ctech4285/EPM_V2_X/V2.50_Documentation/schematic2.jpg

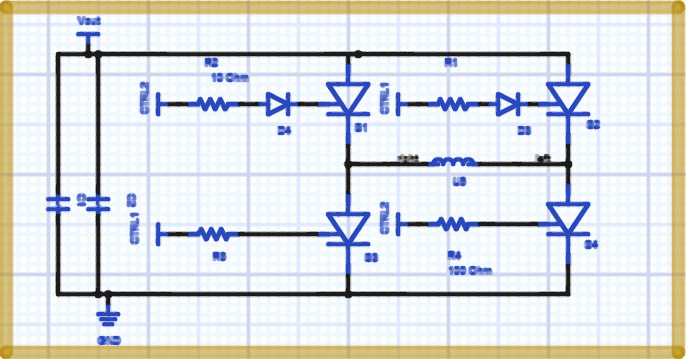
V2.50_Documentation/schematic2.jpg
