ctech4285/EPM_V2_X/PCB Mask R2.50/e768795934e55e3a_gerbers.gbl.png

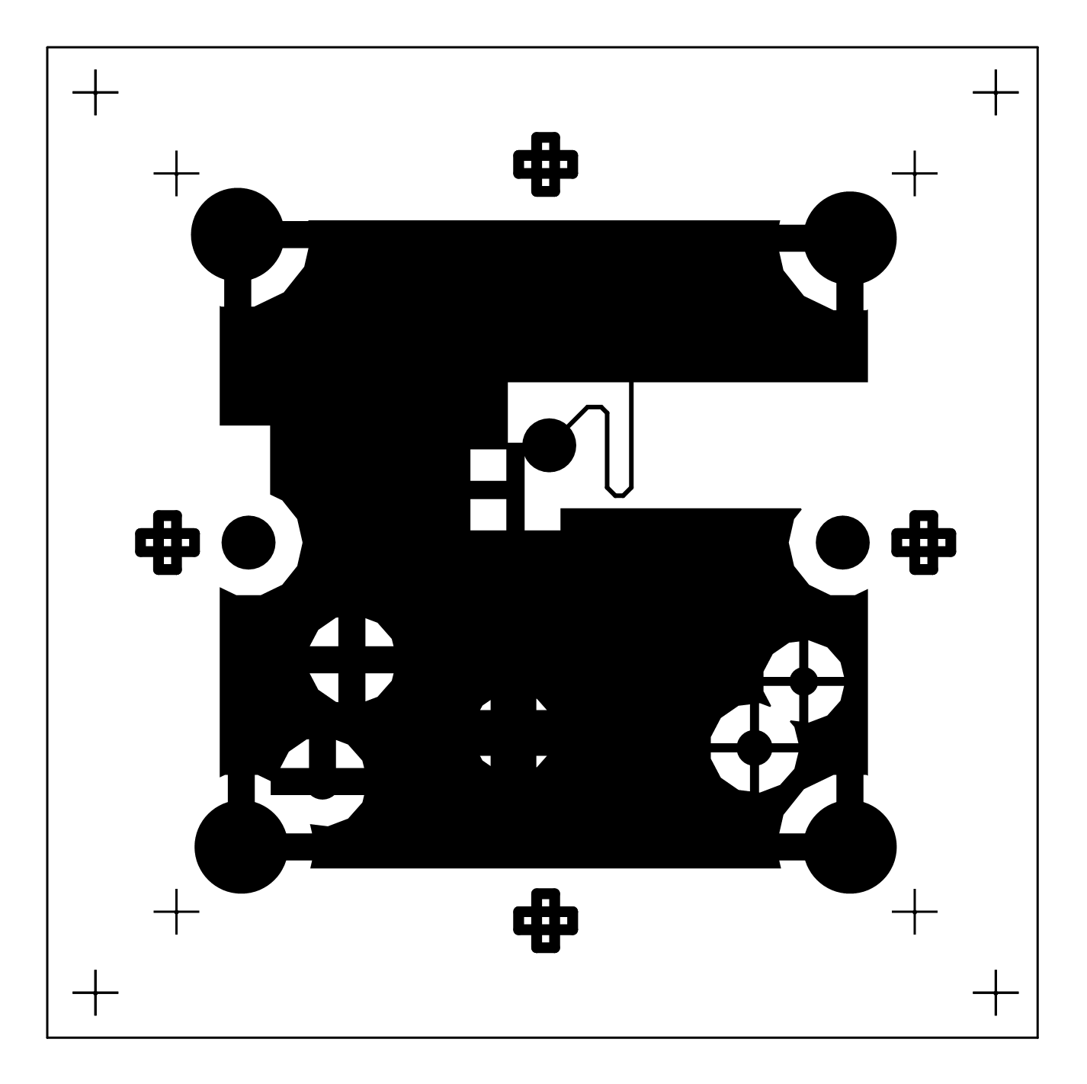
PCB Mask R2.50/e768795934e55e3a_gerbers.gbl.png
