ctech4285/EPM_V2_X/PCB Mask RC6/bottom_copper.ger.png

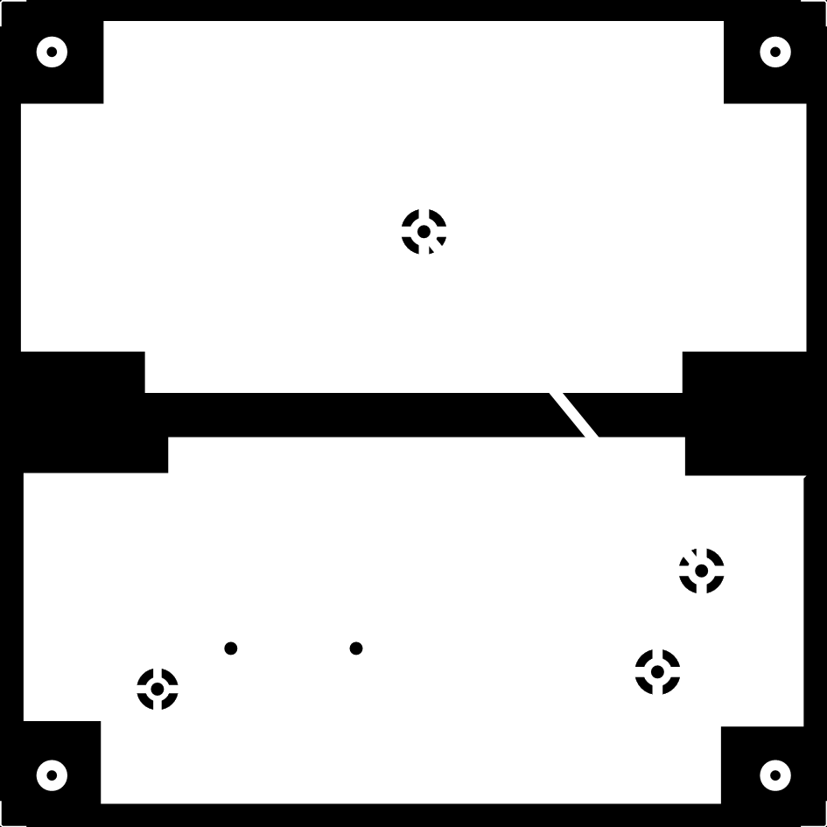
PCB Mask RC6/bottom_copper.ger.png
