ctech4285/EPM_V2_X/PCB Mask RC6/hole.ger.png

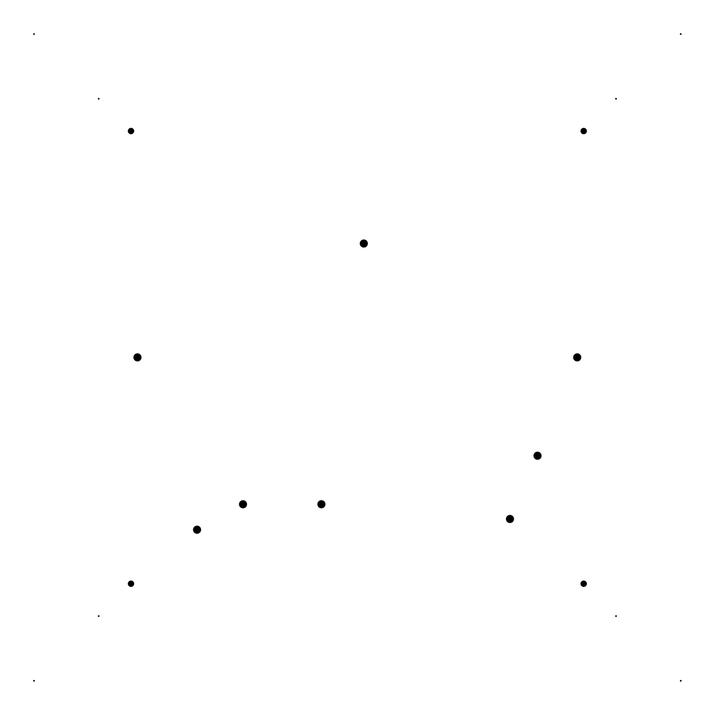
PCB Mask RC6/hole.ger.png
