ctech4285/EPM_V2_X/PCB Mask RC6/mechanical_details.ger.png

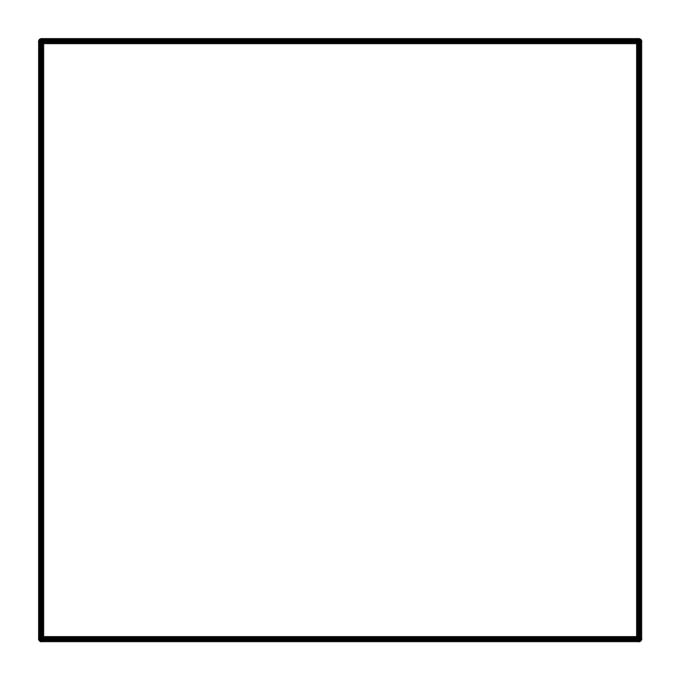
PCB Mask RC6/mechanical_details.ger.png
