ctech4285/EPM_V2_X/PCB Mask RC6/top_silkscreen.ger.png

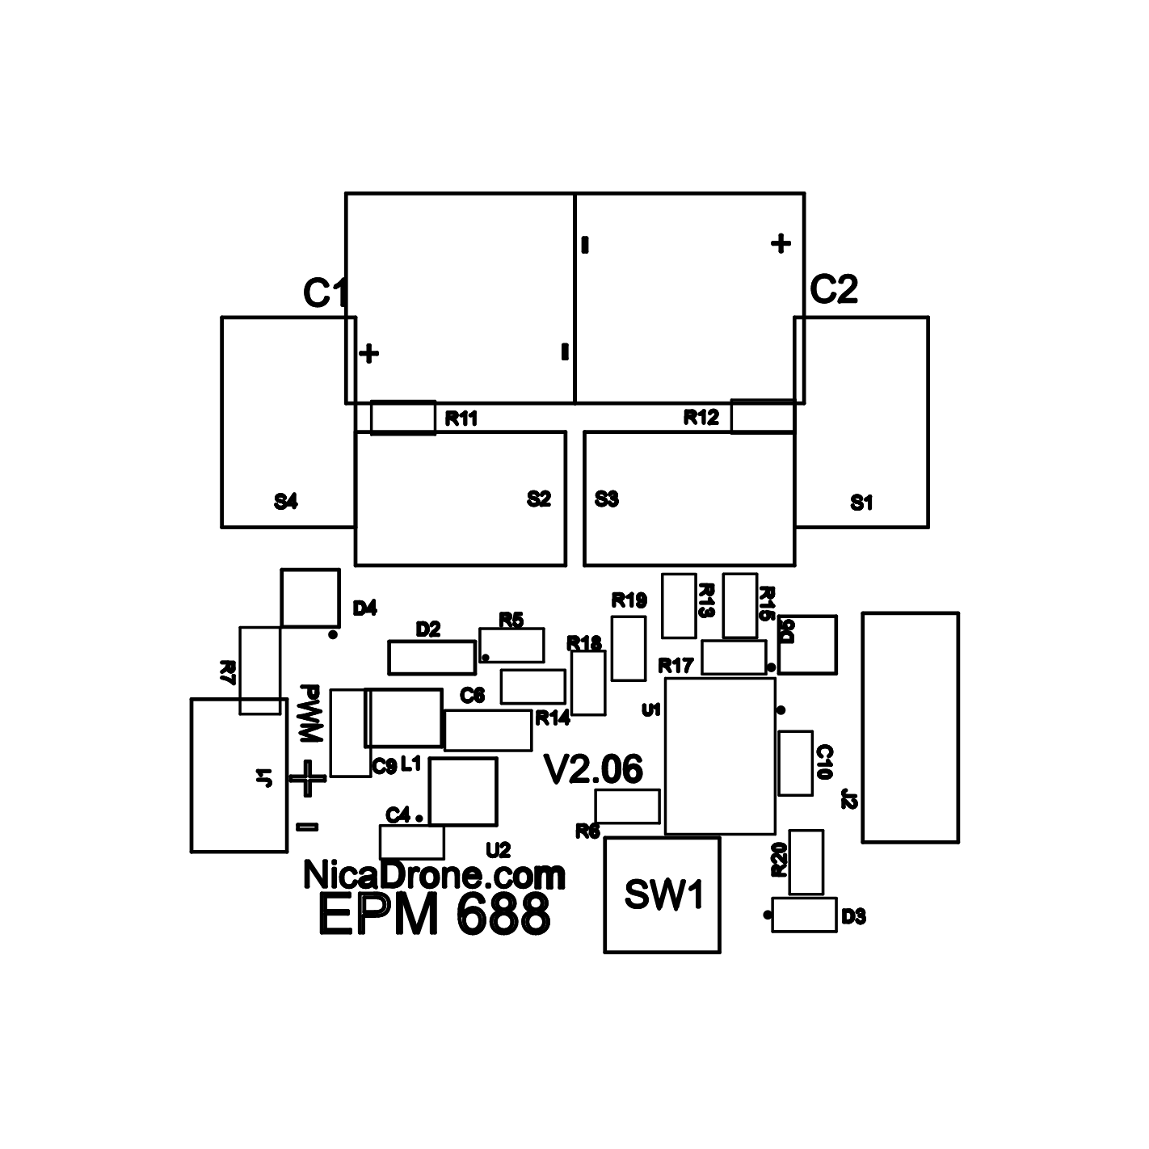
PCB Mask RC6/top_silkscreen.ger.png
