ctech4285/EPM_V2_X/PCB Masks RC5/bottom_copper.ger.png

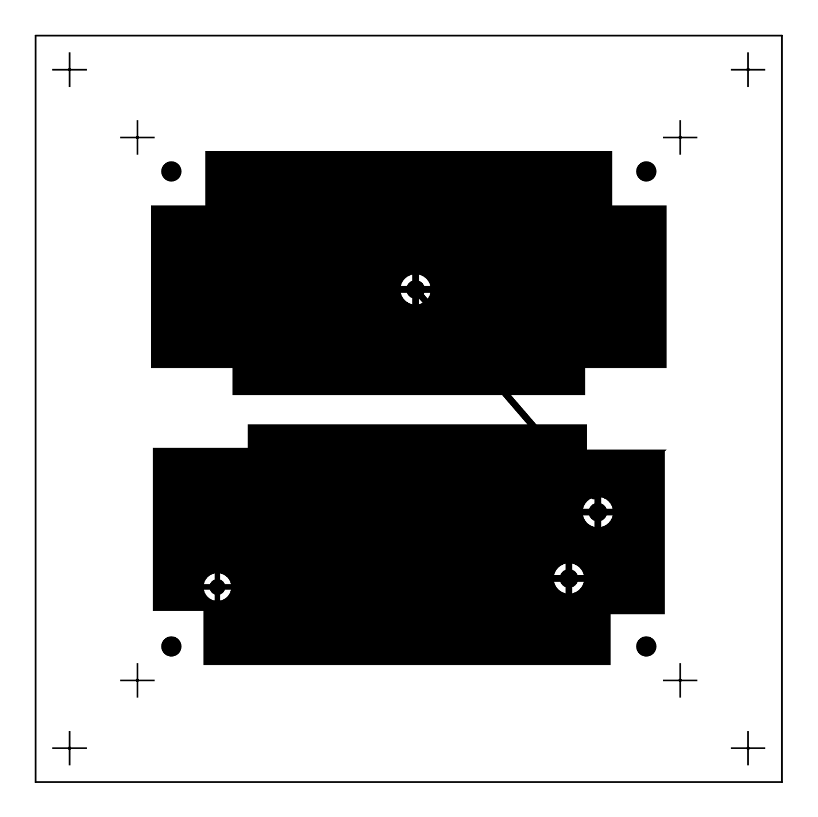
PCB Masks RC5/bottom_copper.ger.png
