ctech4285/EPM_V2_X/PCB Masks RC5/top_silkscreen.ger.png

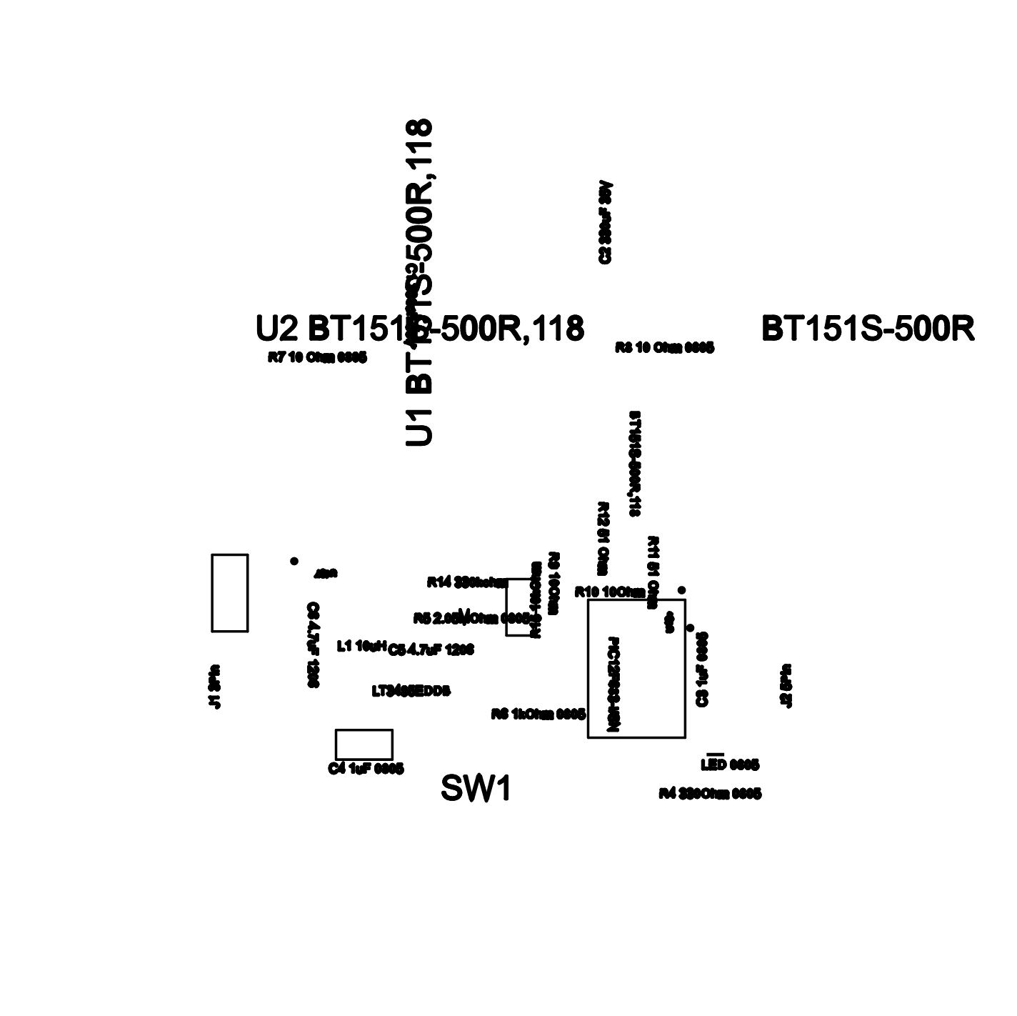
PCB Masks RC5/top_silkscreen.ger.png
