ctech4285/EPM_V2_X/PCB Masks RC8/top_silkscreen.ger.png

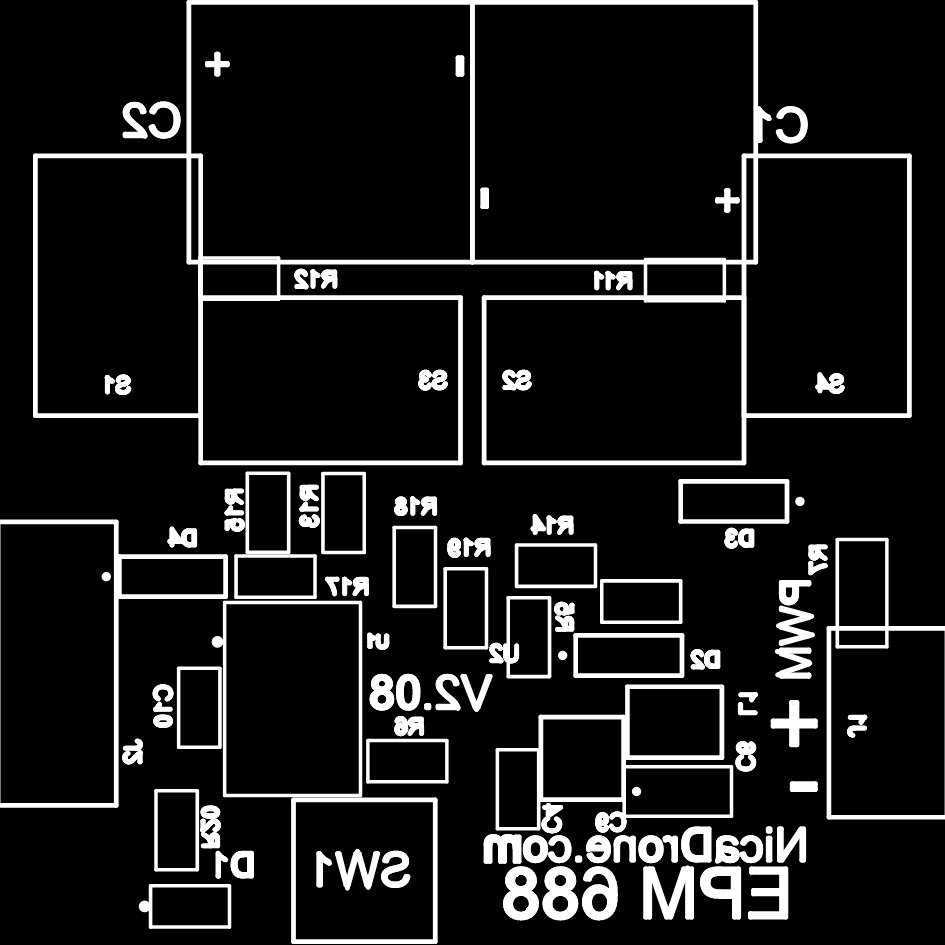
PCB Masks RC8/top_silkscreen.ger.png
