ctech4285/EPM_V2_X/PCB Masks RC9/bottom_copper.ger.png

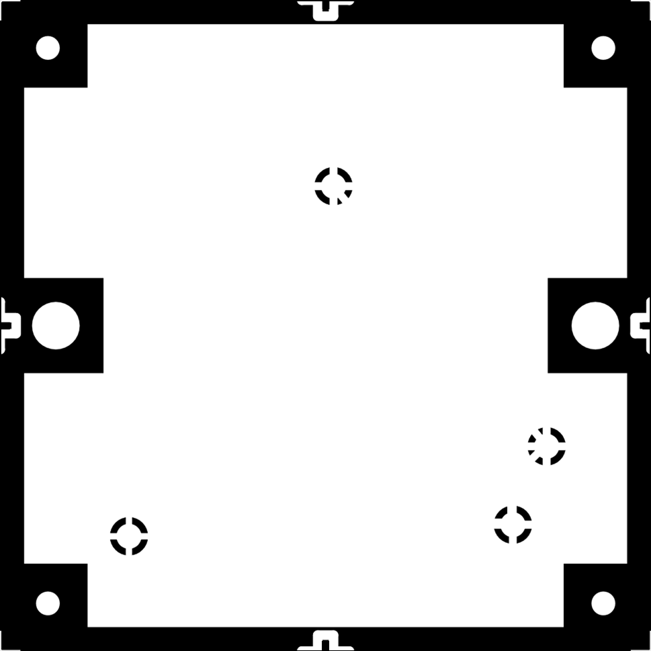
PCB Masks RC9/bottom_copper.ger.png
