ctech4285/EPM_V2_X/PCB Masks RC9/top_copper.ger.png

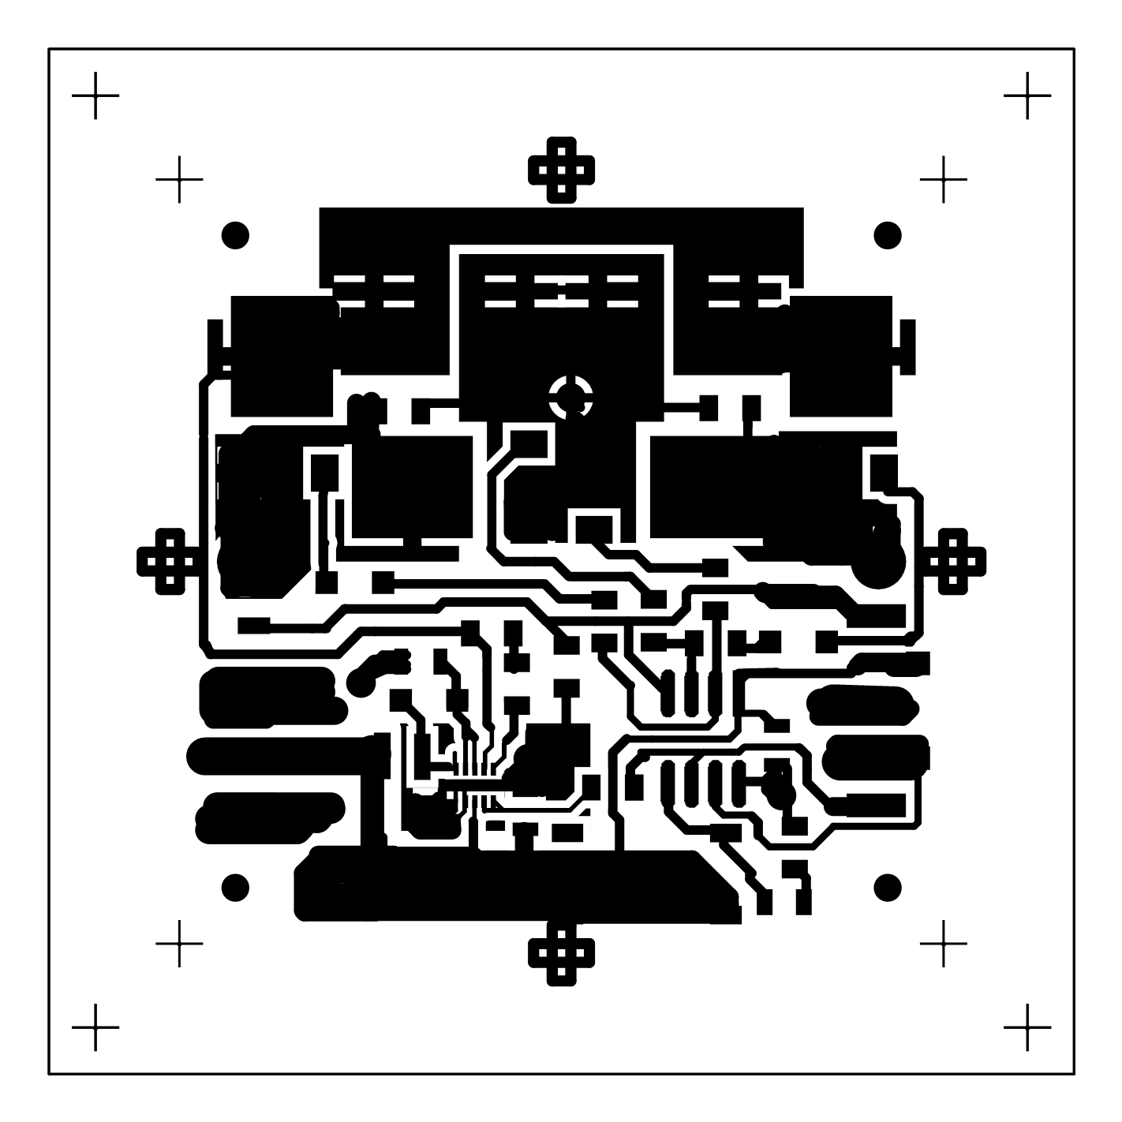
PCB Masks RC9/top_copper.ger.png
