ctech4285/EPM_V2_X/V2.50_Documentation/Drawing.jpg

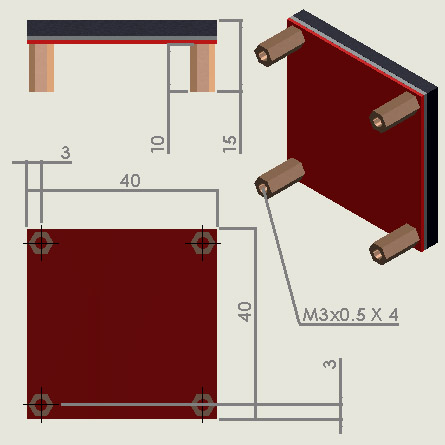
V2.50_Documentation/Drawing.jpg
