ctech4285/EPM_V2_X/V2.50_Documentation/EPM688_V2.5_Datasheet_files/image004.png

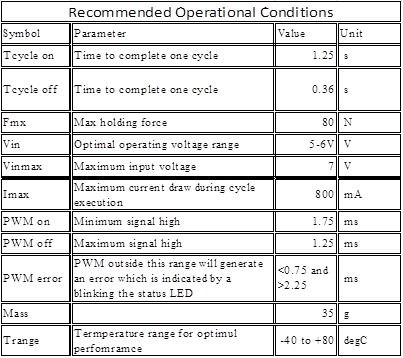
V2.50_Documentation/EPM688_V2.5_Datasheet_files/image004.png
