ctech4285/EPM_V2_X/V2.50_Documentation/EPM688_V2.5_Datasheet_files/image006.jpg

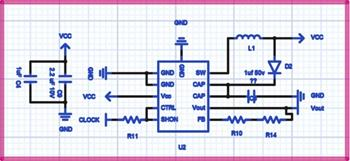
V2.50_Documentation/EPM688_V2.5_Datasheet_files/image006.jpg
