ctech4285/EPM_V2_X/V2.50_Documentation/table.jpg

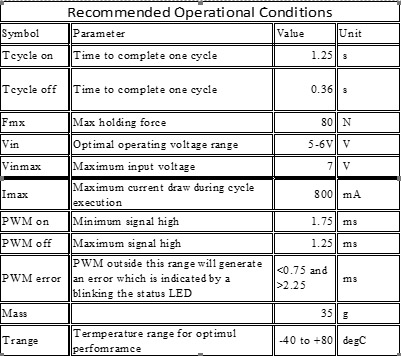
V2.50_Documentation/table.jpg
