ctech4285/EPM_V2_X/parts_drawings/mag_asm.SLDASM

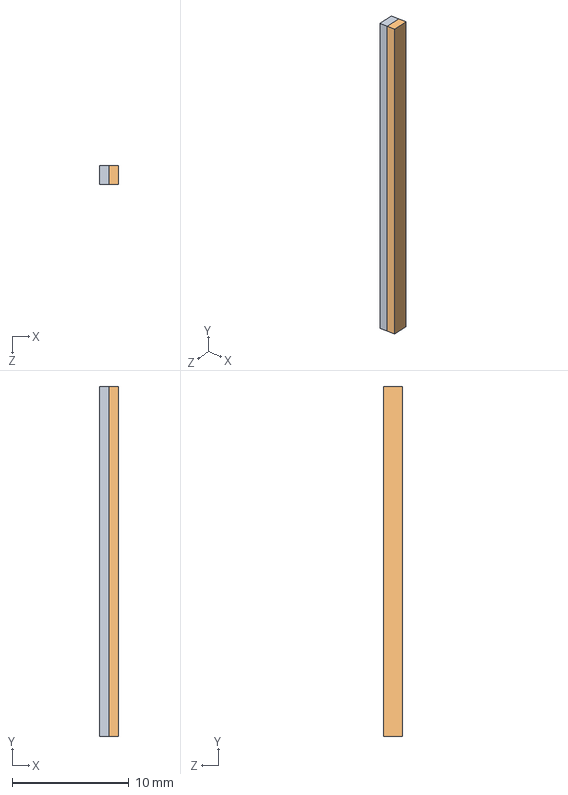
[picture p32: CAD file, 2015-02-20]
parts_drawings/mag_asm.SLDASM
1.60 x 30.0 x 1.60 mm
alnico_mag
Neo_mag
