ctech4285/EPM_V2_X/parts_drawings/Assem1.SLDASM

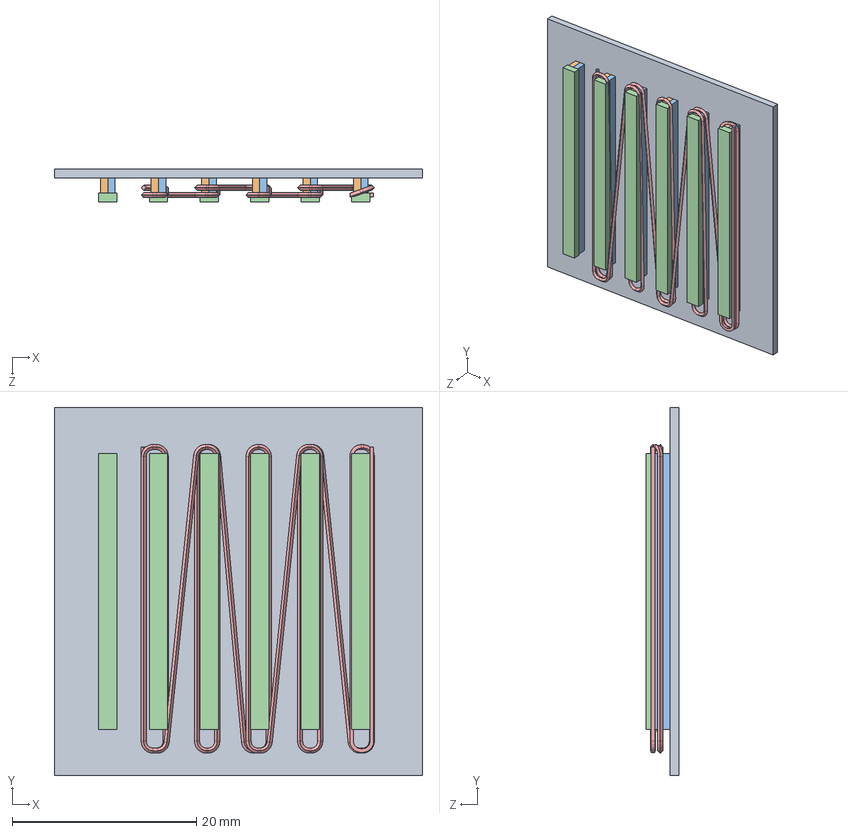
[picture p33: CAD file, 2015-02-20]
parts_drawings/Assem1.SLDASM
40.0 x 40.0 x 3.60 mm
alnico_mag x 6
Neo_mag x 6
base_header x 6
winding
