ctech4285/EPM_V2_X/parts_drawings/mag_asm_4 - mag_asm-1 alnico_mag-1.STL

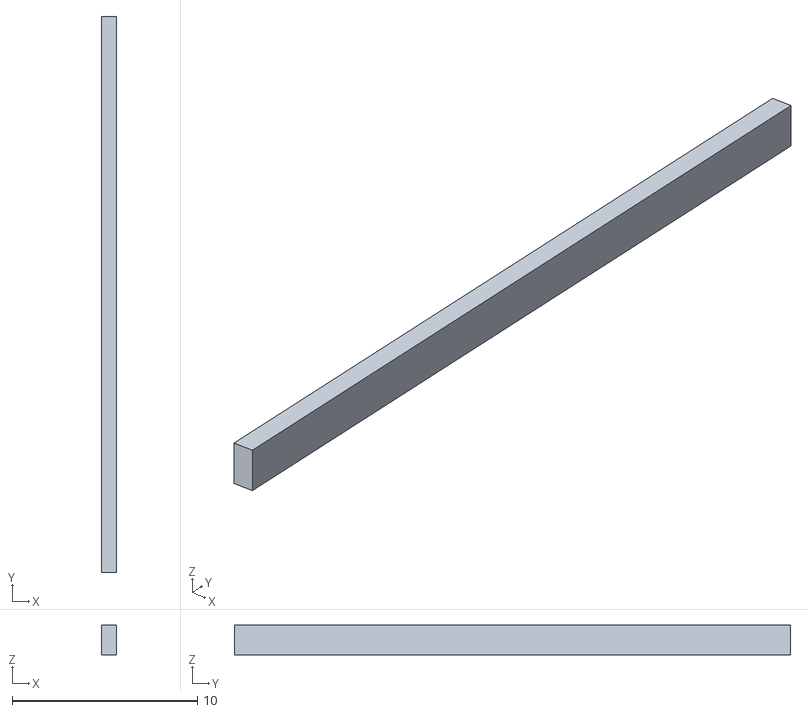
[picture p34: CAD file, 2015-02-20]
parts_drawings/mag_asm_4 - mag_asm-1 alnico_mag-1.STL
0.8 x 30.0 x 1.60
