ctech4285/EPM_V2_X/parts_drawings/mag_asm_4.SLDASM

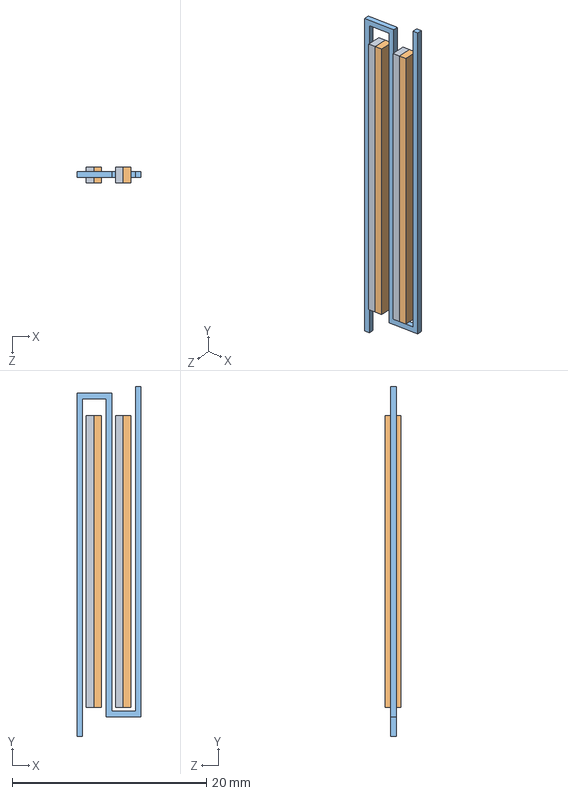
[picture p35: CAD file, 2015-02-20]
parts_drawings/mag_asm_4.SLDASM
6.60 x 36.0 x 1.60 mm
alnico_mag x 2
Neo_mag x 2
winding
