ctech4285/EPM_V2_X/parts_drawings/EPM688_V2.SLDASM

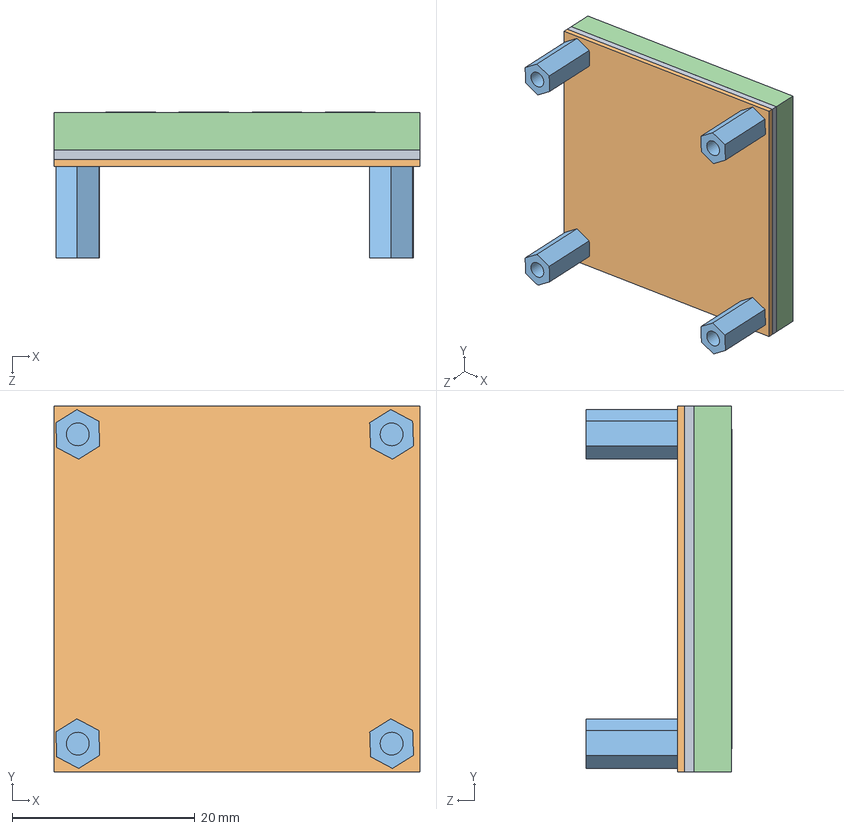
[picture p36: CAD file, 2015-02-20]
parts_drawings/EPM688_V2.SLDASM
40.0 x 40.0 x 16.0 mm
1559_B
pcb
standoff x 4
asasdfsdaf
