ctech4285/EPM_V2_X/parts_drawings/mag_asm_4 - winding-1.STL

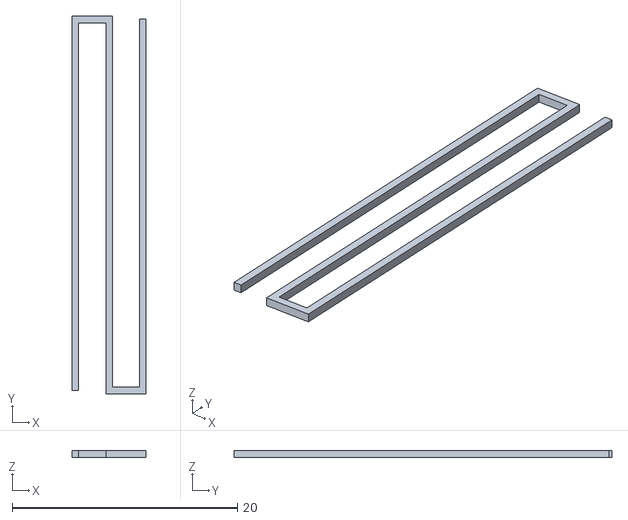
[picture p37: CAD file, 2015-02-20]
parts_drawings/mag_asm_4 - winding-1.STL
6.60 x 33.6 x 0.6
