ctech4285/EPM_V2_X/parts_drawings/production parts/1548_A.SLDPRT

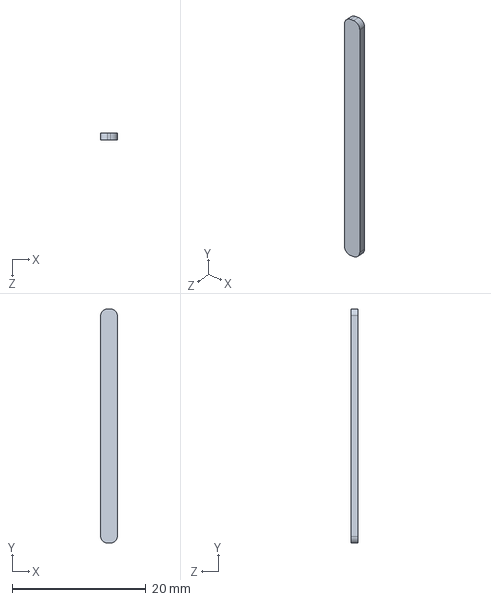
[picture p38: CAD file, 2015-02-20]
parts_drawings/production parts/1548_A.SLDPRT
2.50 x 35.0 x 1.00 mm
