ctech4285/EPM_V2_X/R2.50 winding jig/Winding Jig Drill Guide Top.SLDPRT

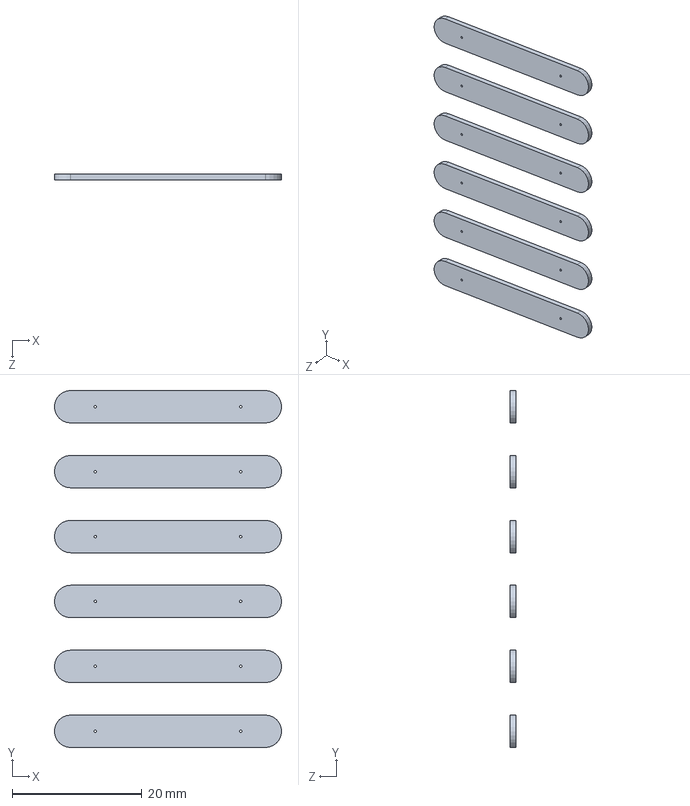
[picture p39: CAD file, 2015-02-20]
R2.50 winding jig/Winding Jig Drill Guide Top.SLDPRT
35.0 x 55.0 x 1.00 mm
