ctech4285/EPM_V2_X/V2.50_Documentation/Drawing.SLDPRT

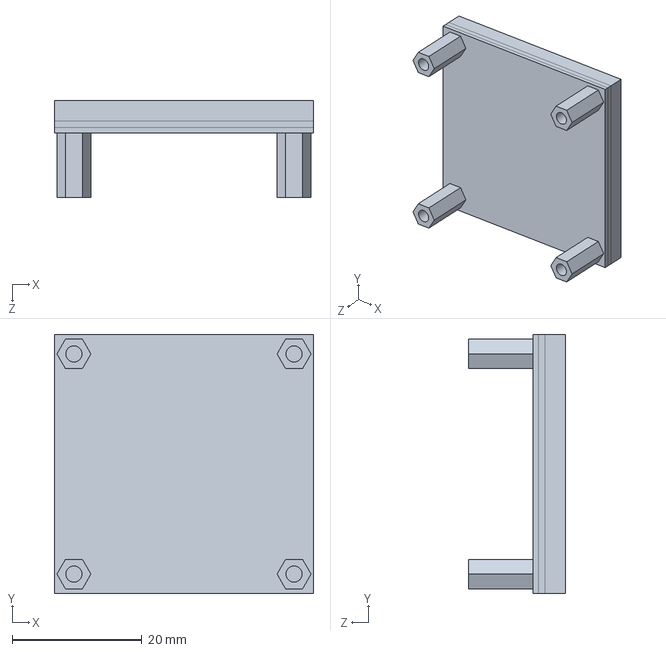
[picture p40: CAD file, 2015-02-20]
V2.50_Documentation/Drawing.SLDPRT
40.0 x 40.0 x 15.0 mm
