ctech4285/EPM_V2_X/parts_drawings/production parts/1548_C.SLDPRT

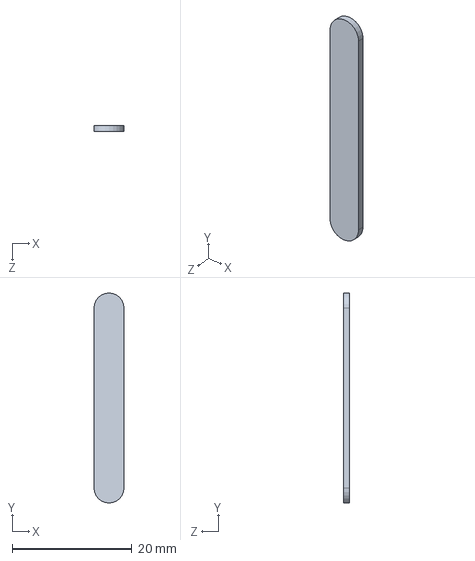
[picture p41: CAD file, 2015-02-20]
parts_drawings/production parts/1548_C.SLDPRT
5.00 x 35.0 x 1.00 mm
