ctech4285/EPM_V2_X/R2.50 winding jig/Winding Jig Drill Guide.SLDPRT

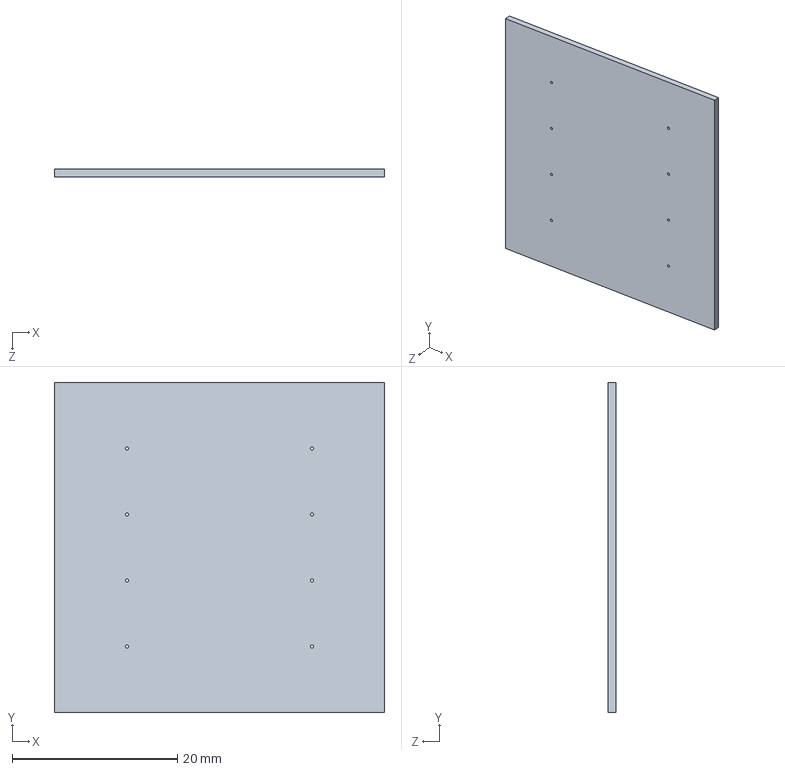
[picture p42: CAD file, 2015-02-20]
R2.50 winding jig/Winding Jig Drill Guide.SLDPRT
40.0 x 40.0 x 1.00 mm
