ctech4285/EPM_V2_X/parts_drawings/production parts/Pilar_stand_off_local_fab.SLDPRT

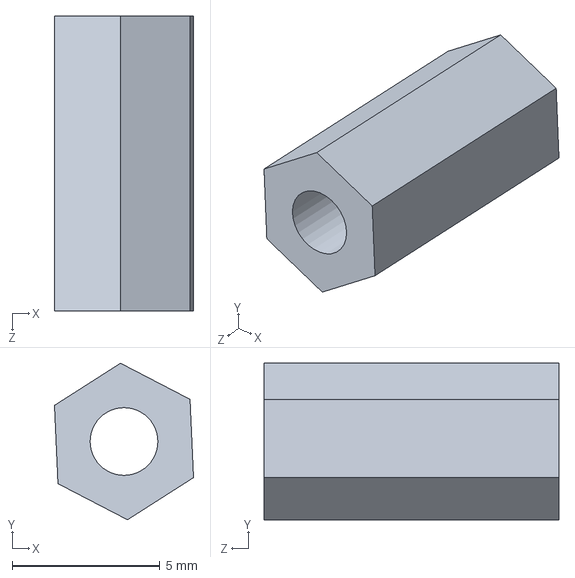
[picture p43: CAD file, 2015-02-20]
parts_drawings/production parts/Pilar_stand_off_local_fab.SLDPRT
4.71 x 5.31 x 10.0 mm
