ctech4285/EPM_V2_X/parts_drawings/base_plate.SLDPRT

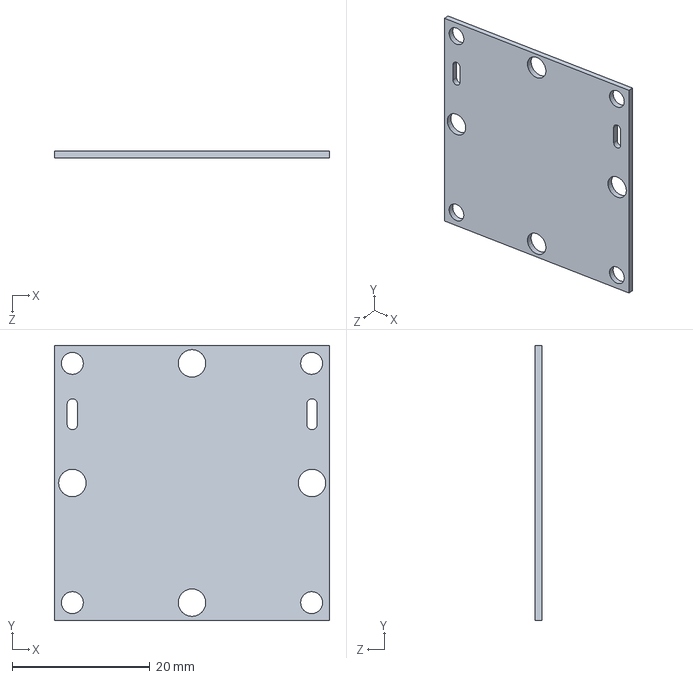
[picture p44: CAD file, 2015-02-20]
parts_drawings/base_plate.SLDPRT
40.0 x 40.0 x 1.00 mm
