ctech4285/EPM_V2_X/parts_drawings/production parts/Pilar_stand_off_local_fab_type_B.SLDPRT

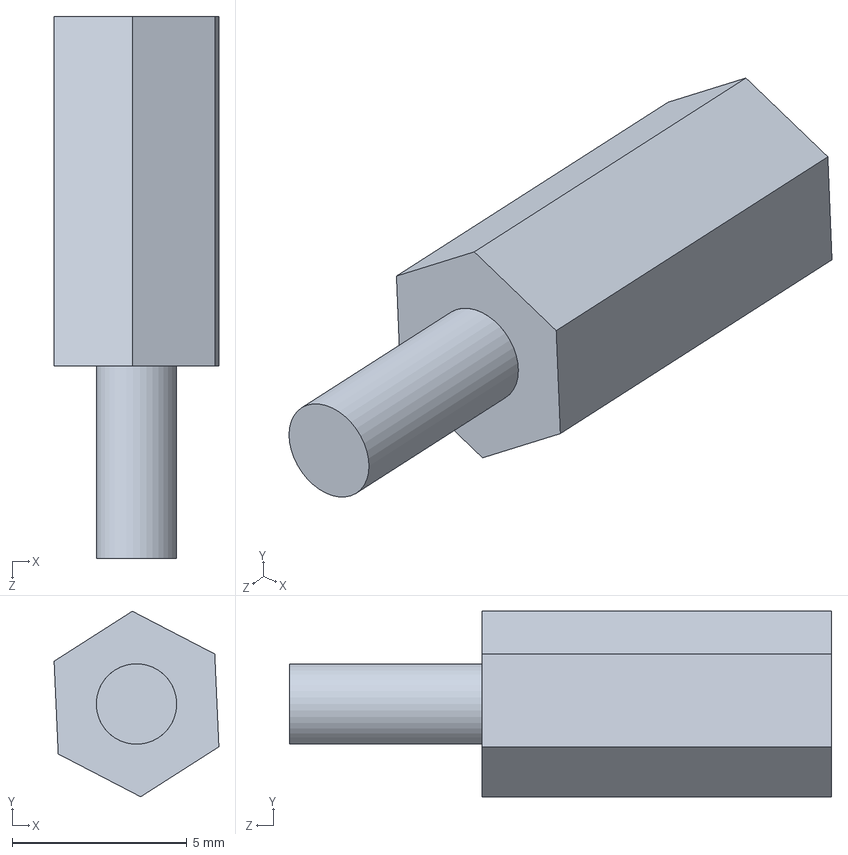
[picture p45: CAD file, 2015-02-20]
parts_drawings/production parts/Pilar_stand_off_local_fab_type_B.SLDPRT
4.71 x 5.31 x 15.5 mm
