ctech4285/EPM_V2_X/parts_drawings/asasdfsdaf.SLDPRT

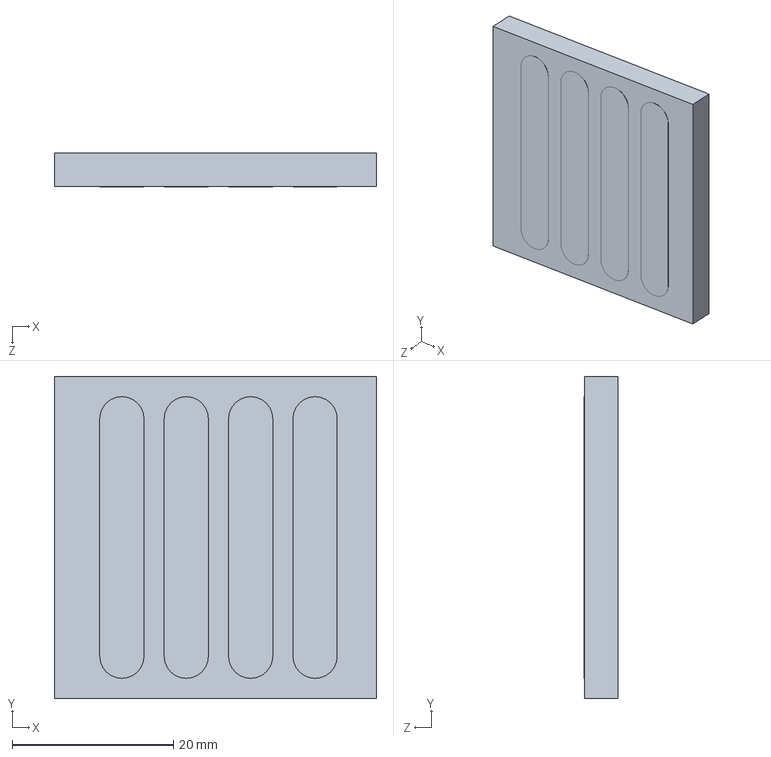
[picture p46: CAD file, 2015-02-20]
parts_drawings/asasdfsdaf.SLDPRT
40.0 x 40.0 x 4.20 mm
