ctech4285/EPM_V2_X/parts_drawings/pin_header.SLDPRT

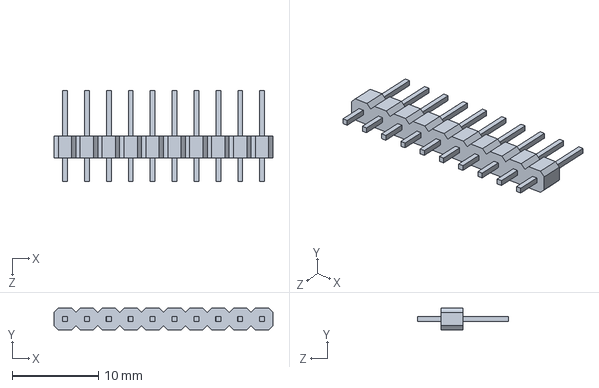
[picture p47: CAD file, 2015-02-20]
parts_drawings/pin_header.SLDPRT
25.4 x 2.54 x 10.5 mm
