ctech4285/EPM_V2_X/parts_drawings/winding_for_sim.SLDPRT

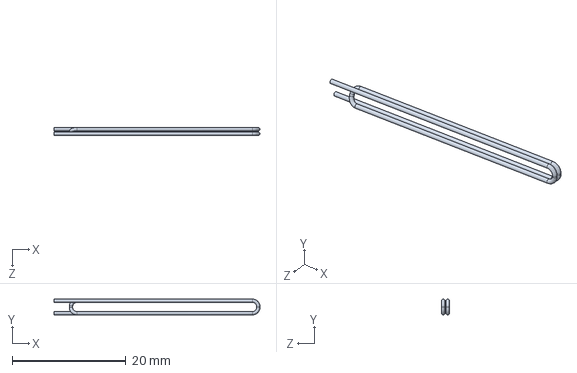
[picture p48: CAD file, 2015-02-20]
parts_drawings/winding_for_sim.SLDPRT
36.3 x 2.80 x 1.40 mm
