ctech4285/EPM_V2_X/parts_drawings/pcb.SLDPRT

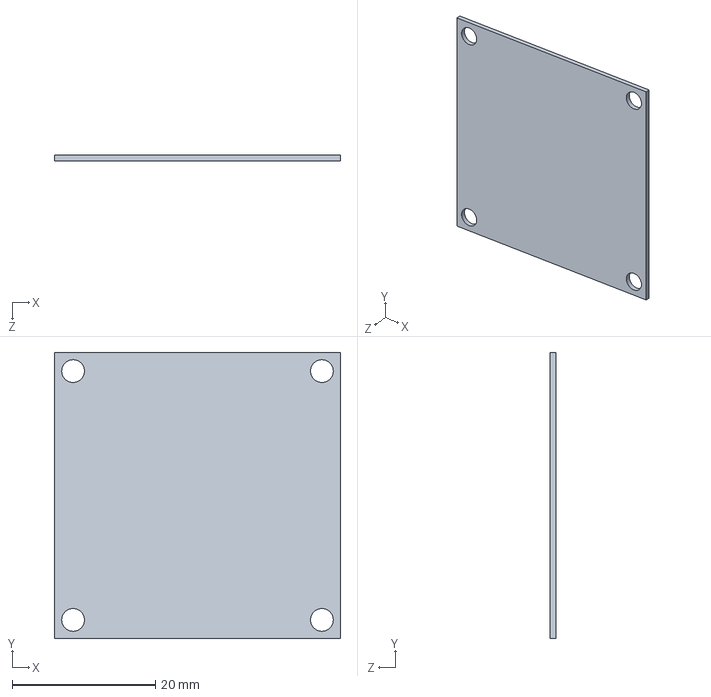
[picture p49: CAD file, 2015-02-20]
parts_drawings/pcb.SLDPRT
40.0 x 40.0 x 0.8 mm
