ctech4285/EPM_V2_X/parts_drawings/330uFcap.SLDPRT

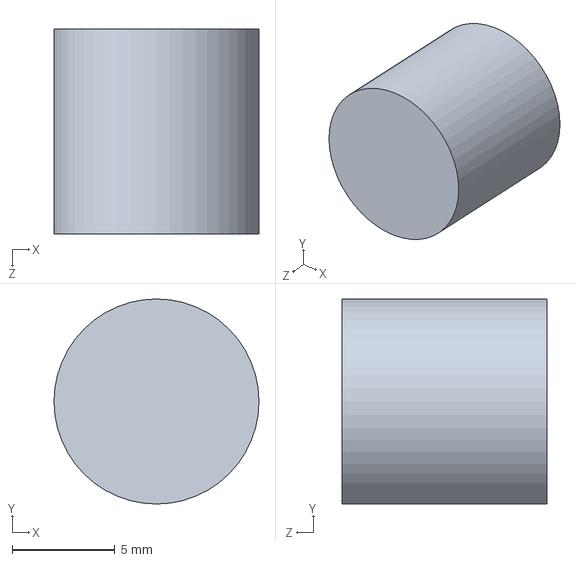
[picture p50: CAD file, 2015-02-20]
parts_drawings/330uFcap.SLDPRT
10.0 x 10.0 x 10.0 mm
