ctech4285/EPM_V2_X/parts_drawings/winding.SLDPRT

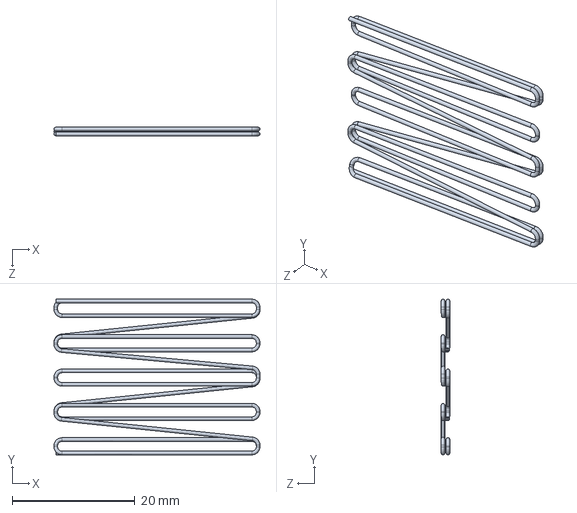
[picture p51: CAD file, 2015-02-20]
parts_drawings/winding.SLDPRT
33.6 x 25.4 x 1.40 mm
