ctech4285/EPM_V2_X/parts_drawings/base_header.SLDPRT

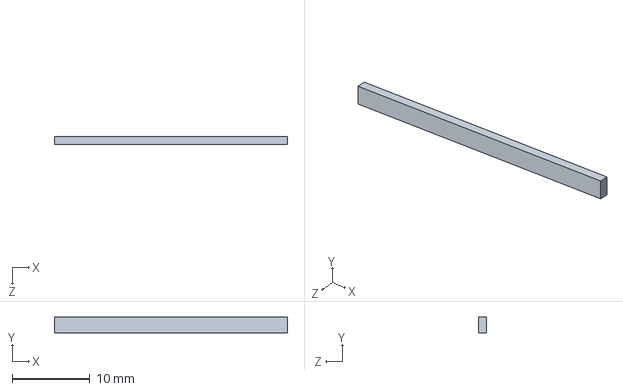
[picture p52: CAD file, 2015-02-20]
parts_drawings/base_header.SLDPRT
30.0 x 2.00 x 1.00 mm
