ctech4285/EPM_V2_X/parts_drawings/giesung.SLDPRT

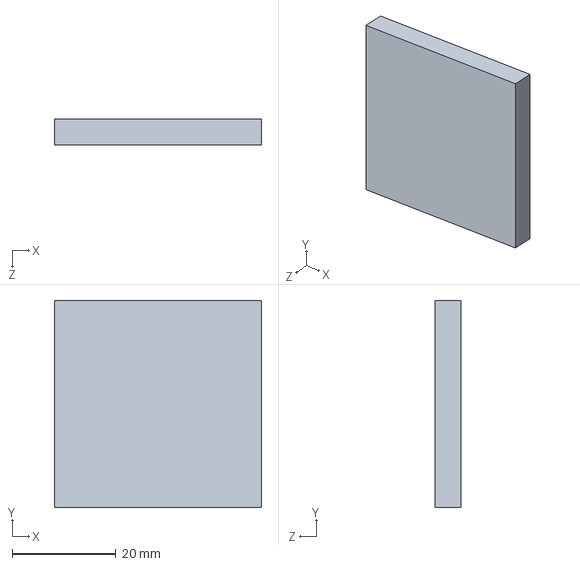
[picture p53: CAD file, 2015-02-20]
parts_drawings/giesung.SLDPRT
40.0 x 40.0 x 5.00 mm
