ctech4285/EPM_V2_X/parts_drawings/standoff.SLDPRT

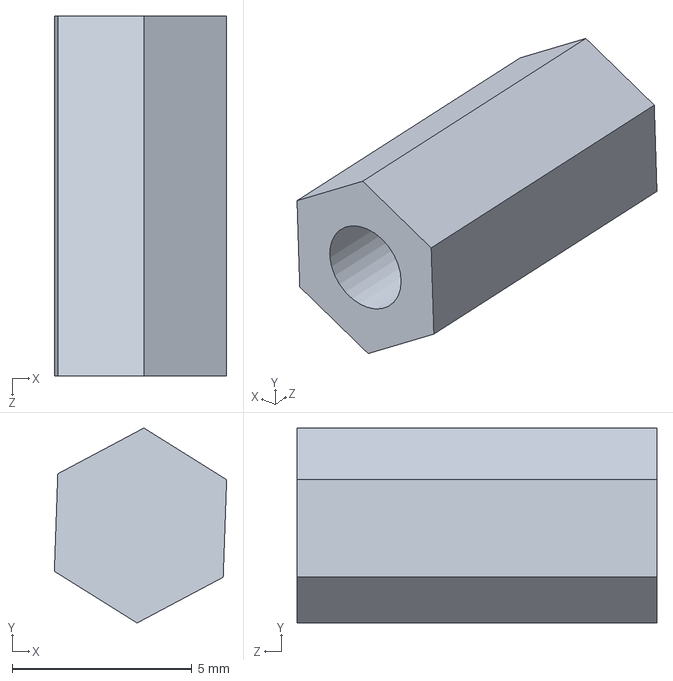
[picture p54: CAD file, 2015-02-20]
parts_drawings/standoff.SLDPRT
4.79 x 5.42 x 10.0 mm
