ctech4285/EPM_V2_X/(list of files, cad)

Other CAD files:
parts_drawings/mag_asm_4 - mag_asm-2 Neo_mag-1.STL
parts_drawings/mag_asm_4 - mag_asm-2 alnico_mag-1.STL
parts_drawings/mag_asm_4 - mag_asm-1 Neo_mag-1.STL
parts_drawings/Assem1asdf.SLDASM
parts_drawings/production parts/1559_A.SLDPRT
parts_drawings/production parts/1559_B.SLDPRT
parts_drawings/alnico_mag.SLDPRT
parts_drawings/Neo_mag.SLDPRT
parts_drawings/1559_B.SLDPRT
parts_drawings/temp.SLDPRT
R2.50 winding jig/Alnico_magnet_RC3.SLDDRW
V2.50_Documentation/Drawing.SLDDRW
parts_drawings/Assem1asdf.SLDDRW
parts_drawings/M3_12mm.SLDPRT
parts_drawings/NCR18650A_Cell.SLDPRT
parts_drawings/production parts/1448_A.SLDDRW
parts_drawings/production parts/1548_A.SLDDRW
parts_drawings/production parts/1548_C.SLDDRW
parts_drawings/production parts/1559_A.SLDDRW
parts_drawings/production parts/1559_B.SLDDRW
parts_drawings/production parts/Pilar_stand_off_local_fab.SLDDRW
parts_drawings/production parts/Pilar_stand_off_local_fab_type_B.SLDDRW
