ctech4285/EPM_V2_X/V2.50_Documentation/Recomended Operating Condition for Datasheet.xlsx

Recommended Operational Conditions
Symbol | Parameter | Value | Unit
Tcycle on | Time to complete one cycle | 1.25 | s
Tcycle off | Time to complete one cycle | 0.36 | s
Fmx | Max holding force | 80 | N
Vin | Optimal operating voltage range | 5-6V | V
Vinmax | Maximum input voltage | 7 | V
Imax | Maximum current draw during cycle execution | 800 | mA
PWM on | Minimum signal high | 1.75 | ms
PWM off | Maximum signal high | 1.25 | ms
PWM error | PWM outside this range will generate an error which is indicated by a blinking the status LED | <0.75 and >2.25 | ms
Mass |  | 35 | g
Trange | Termperature range for optimul perfomramce | -40 to +80 | degC
