ctech4285/EPM_V2_X/PCB Mask RC6/bottom_solder_mask.ger.png

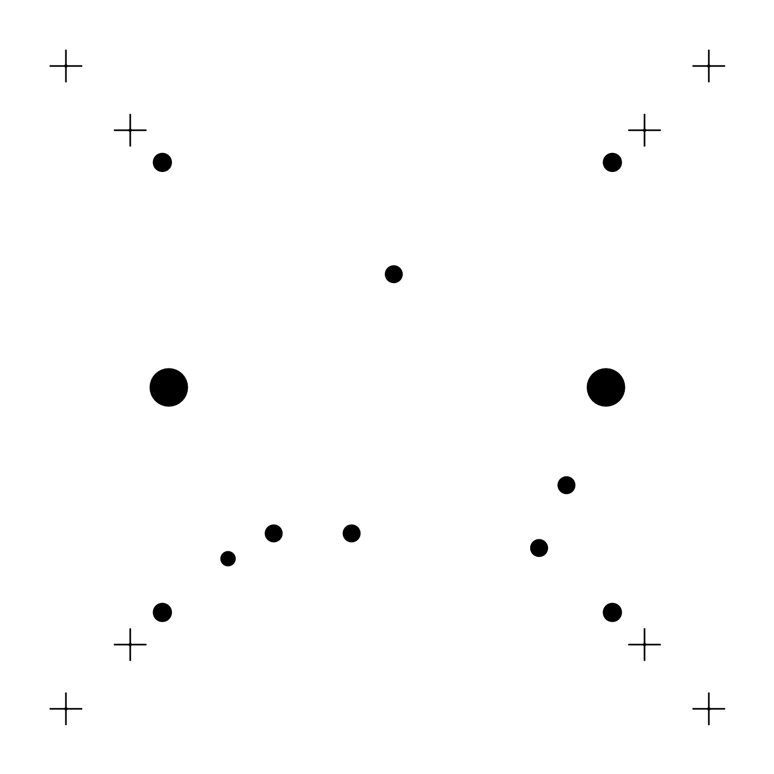
PCB Mask RC6/bottom_solder_mask.ger.png
