ctech4285/EPM_V2_X/R2.50 winding jig/Winding Jig Drill Guide Top.JPG

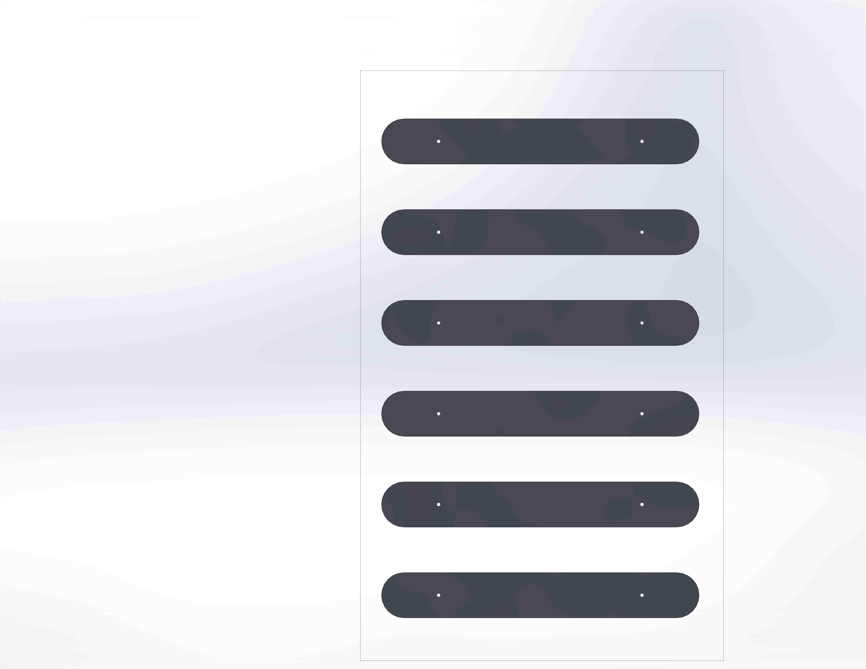
R2.50 winding jig/Winding Jig Drill Guide Top.JPG
