ctech4285/EPM_V2_X/order_drawing/1248_B.PDF

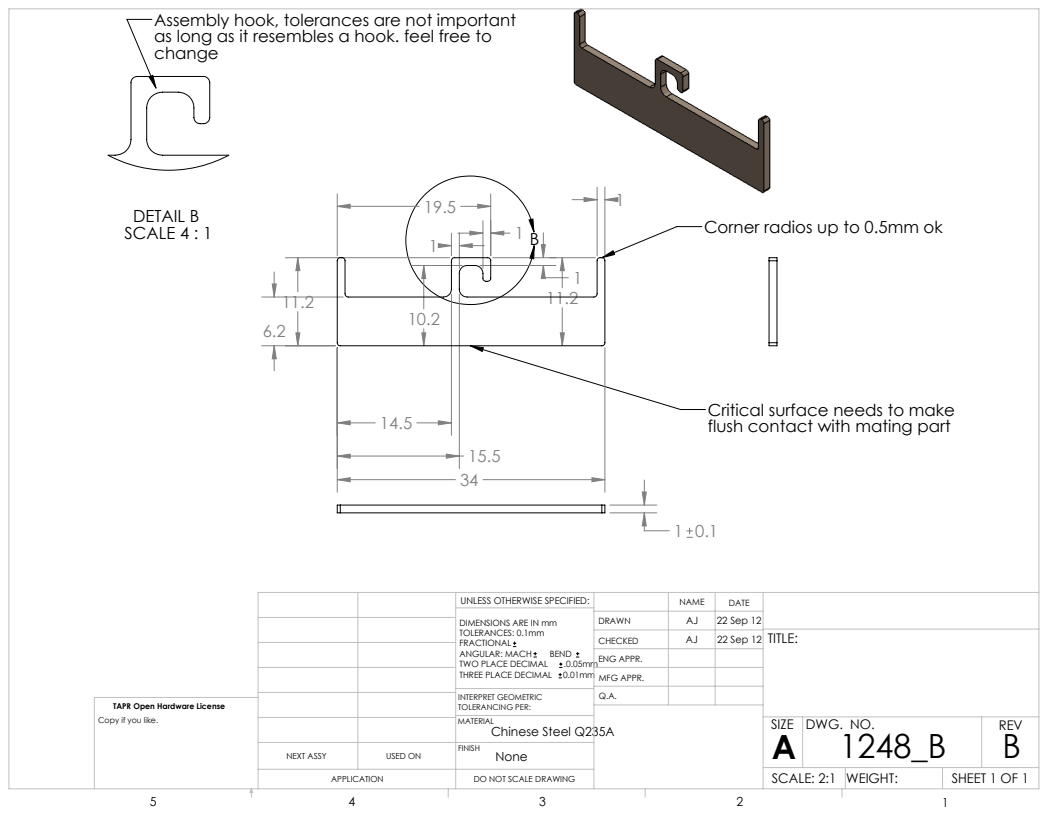
[picture p60: page 1]
Corner radios up to 0.5mm ok; DETAIL B SCALE 4 : 1; SHEET 1 OF 1; 22 Sep 12; SCALE: 2:1 WEIGHT:; DWG. NO.; REV; MFG APPR.; ENG APPR.; Chinese Steel Q235A; INTERPRET GEOMETRIC TOLERANCING PER:; ANGULAR: MACH; BEND; TWO PLACE DECIMAL; NEXT ASSY; USED ON

Assembly hook, tolerances are not important
as long as it resembles a hook. feel free to
change

Critical surface needs to make
flush contact with mating part

UNLESS OTHERWISE SPECIFIED:

DIMENSIONS ARE IN mm
TOLERANCES: 0.1mm
FRACTIONAL
THREE PLACE DECIMAL 0.01mm

TAPR Open Hardware License
Copy if you like.

DO NOT SCALE DRAWING
