ctech4285/EPM_V2_X/order_drawing/1548_C.pdf

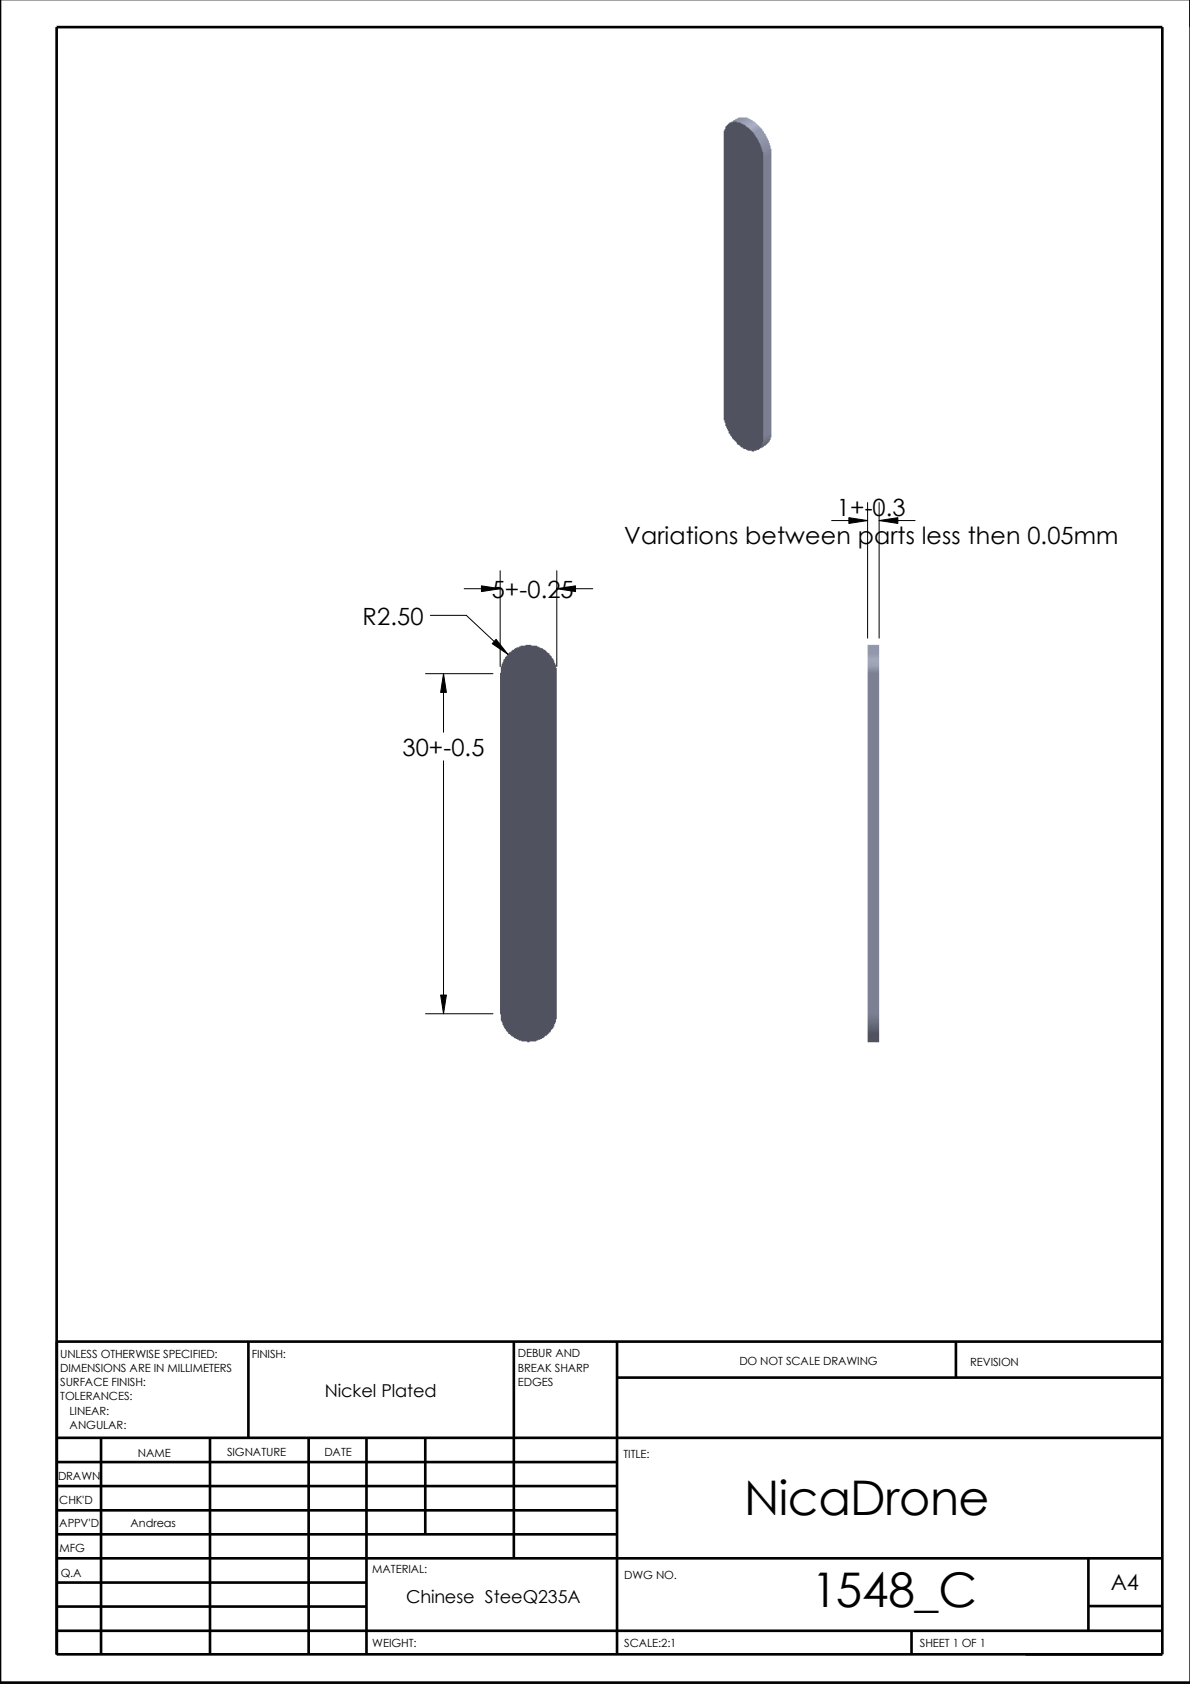
[picture p61: page 1]
Nickel Plated; WEIGHT:; SCALE:2:1; SHEET 1 OF 1; DO NOT SCALE DRAWING; REVISION; FINISH:; BREAK SHARP EDGES; UNLESS OTHERWISE SPECIFIED:; DEBUR AND

Variations between parts less then 0.05mm

DIMENSIONS ARE IN MILLIMETERS
SURFACE FINISH:
TOLERANCES:
LINEAR:
ANGULAR:

NAME | SIGNATURE | DATE | | | | TITLE: NicaDrone

DRAWN

CHK'D

APPV'D | Andreas

MFG

Q.A | | | | MATERIAL: Chinese SteeQ235A | DWG NO. 1548_C | A4
